arquero99/E-TEASPILS/img/16494115421077082039803952623791.png

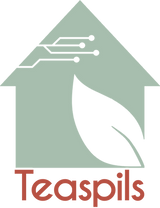
img/16494115421077082039803952623791.png
