arquero99/E-TEASPILS/img/IMG20220531001731-01.jpeg

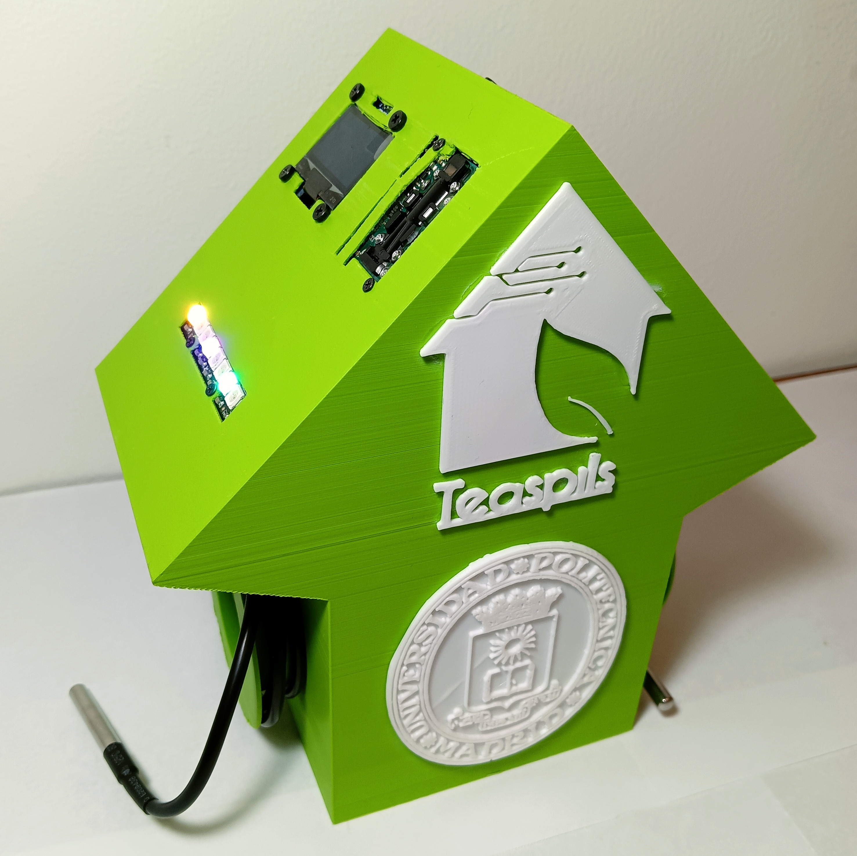
img/IMG20220531001731-01.jpeg
