arquero99/E-TEASPILS/img/pinout.jpg

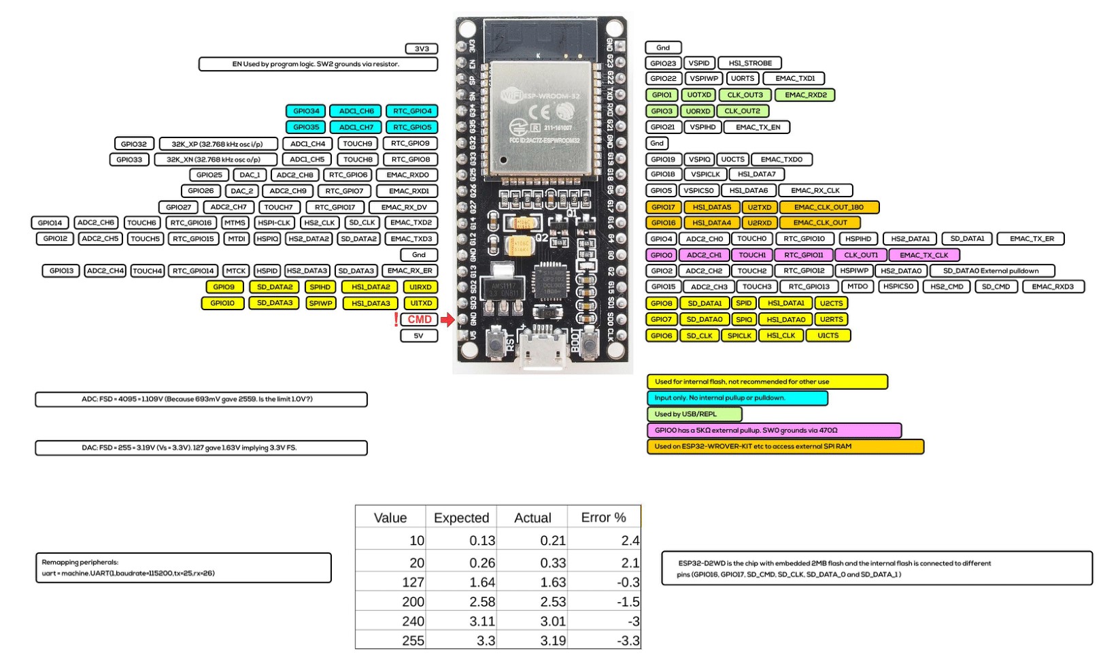
img/pinout.jpg
