arquero99/E-TEASPILS/SW/TB TeaSpike/Datasets/Dataset semanal/Semanal(7-02_15_02).png

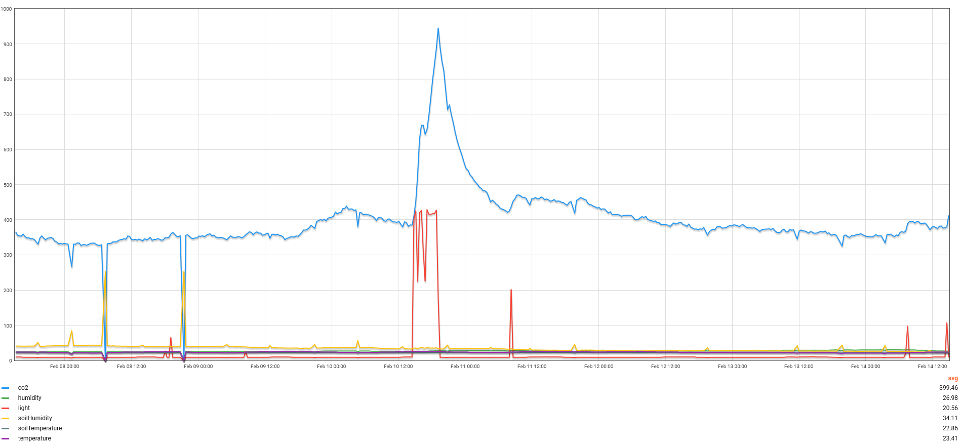
SW/TB TeaSpike/Datasets/Dataset semanal/Semanal(7-02_15_02).png
