arquero99/E-TEASPILS/HW/resources/Components.xlsx

Sheet: TeaSpike v1
Column1 | Column2 | Column3 | Column4 | Column5 | Column6 | Column7 | Column8 | Column9 | Link Compra
Source: | E:\Teaspils\E-TEASPILS\HW\KiCad project\TeaSpike v1\TeaSpike v1.kicad_sch
Date: | 18/04/2022 19:10:47
Tool: | Eeschema (6.0.4)
Generator: | E:\Programas\KiCad\6.0\bin\scripting\plugins/bom_csv_grouped_by_value.py
Component Count: | 24
Individual Components:
Item | Qty | Reference(s) | Value | LibPart | Footprint | Datasheet | MANUFACTURER | PARTREV
 |  | Batterycon1 | Conn_01x02 | Connector_Generic:Conn_01x02 | TerminalBlock:TerminalBlock_bornier-2_P5.08mm | ~
 |  | D1 | 1N4001 | Diode:1N4001 | Diode_THT:D_DO-41_SOD81_P10.16mm_Horizontal | http://www.vishay.com/docs/88503/1n4001.pdf
 |  | DISPLAYcon1 | Conn_01x04 | Connector_Generic:Conn_01x04 | Connector_JST:JST_EH_B4B-EH-A_1x04_P2.50mm_Vertical | ~
 |  | ESP32 | ESP32-DEVKITC-32D | ESP32-DEVKITC-32D:ESP32-DEVKITC-32D | ESP32-DEVKITC-32D:MODULE_ESP32-DEVKITC-32D |  | Espressif Systems | 4
 |  | I2Ccon1 | Conn_01x04 | Connector_Generic:Conn_01x04 | Connector_PinSocket_2.54mm:PinSocket_1x04_P2.54mm_Vertical | ~
 |  | JP1 | Jumper_2_Open | Jumper:Jumper_2_Open | Connector_PinHeader_2.54mm:PinHeader_1x02_P2.54mm_Vertical | ~
 |  | LEDSTRIPEcon1 | Conn_01x04 | Connector_Generic:Conn_01x04 | Connector_JST:JST_EH_B4B-EH-A_1x04_P2.50mm_Vertical | ~
 |  | NEOPIXELcon1 | Conn_02x02_Odd_Even | Connector_Generic:Conn_02x02_Odd_Even | Connector_PinSocket_2.54mm:PinSocket_2x02_P2.54mm_Vertical | ~
 |  | PowerSupplycon1 | Conn_01x03 | Connector_Generic:Conn_01x03 | Connector_PinSocket_2.54mm:PinSocket_1x03_P2.54mm_Vertical | ~
 |  | R1 | 1K | Device:R | Resistor_THT:R_Axial_DIN0207_L6.3mm_D2.5mm_P7.62mm_Horizontal | ~
 |  | R2 | 2K | Device:R | Resistor_THT:R_Axial_DIN0207_L6.3mm_D2.5mm_P7.62mm_Horizontal | ~
 |  | RTemp1 | 4K7 | Device:R | Resistor_THT:R_Axial_DIN0207_L6.3mm_D2.5mm_P7.62mm_Horizontal | ~
 |  | RTemp2 | 4K7 | Device:R | Resistor_THT:R_Axial_DIN0207_L6.3mm_D2.5mm_P7.62mm_Horizontal | ~
 |  | SDC30con1 | Conn_01x05 | Connector_Generic:Conn_01x05 | Connector_JST:JST_EH_B5B-EH-A_1x05_P2.50mm_Vertical | ~
 |  | SoilMoisturecon1 | Conn_01x03 | Connector_Generic:Conn_01x03 | Connector_PinHeader_2.54mm:PinHeader_1x03_P2.54mm_Vertical | ~
 |  | Solarcon1 | SolarPannel | Connector_Generic:Conn_01x02 | TerminalBlock:TerminalBlock_bornier-2_P5.08mm | ~
 |  | SW1 | SW_DPDT_x2 | Switch:SW_DPDT_x2 | Button_Switch_THT:SW_CuK_JS202011AQN_DPDT_Angled | ~
 |  | TempProbe1 | Conn_01x03 | Connector_Generic:Conn_01x03 | Connector_JST:JST_EH_B3B-EH-A_1x03_P2.50mm_Vertical | ~
 |  | TempProbe2 | Conn_01x03 | Connector_Generic:Conn_01x03 | Connector_JST:JST_EH_B3B-EH-A_1x03_P2.50mm_Vertical | ~
 |  | U1 | TP4056 | TeaSpike_Periferalls:TP4056 | TeaSpike_Periferalls:TP4056
 |  | U2 | PowerBoost | TeaSpike_Periferalls:PowerBoost | TeaSpike_Periferalls:PowerBoost
 |  | U_RTC1 | RTC_I2C_Module | TeaSpike_Periferalls:RTC_I2C_Module | TeaSpike_Periferalls:RTC_I2C_Module
 |  | U_SD1 | SD_Module | TeaSpike_Periferalls:SD_Module | TeaSpike_Periferalls:SD_Module
 |  | VEML7700con1 | Conn_01x04 | Connector_Generic:Conn_01x04 | Connector_JST:JST_EH_B4B-EH-A_1x04_P2.50mm_Vertical | ~
Collated Components:
Item | Qty | Reference(s) | Value | LibPart | Footprint | Datasheet | MANUFACTURER | PARTREV
1 | 1 | Batterycon1 | Conn_01x02 | Connector_Generic:Conn_01x02 | TerminalBlock:TerminalBlock_bornier-2_P5.08mm | ~
2 | 1 | D1 | 1N4001 | Diode:1N4001 | Diode_THT:D_DO-41_SOD81_P10.16mm_Horizontal | http://www.vishay.com/docs/88503/1n4001.pdf
3 | 3 | DISPLAYcon1, LEDSTRIPEcon1, VEML7700con1 | Conn_01x04 | Connector_Generic:Conn_01x04 | Connector_JST:JST_EH_B4B-EH-A_1x04_P2.50mm_Vertical | ~
4 | 1 | ESP32 | ESP32-DEVKITC-32D | ESP32-DEVKITC-32D:ESP32-DEVKITC-32D | ESP32-DEVKITC-32D:MODULE_ESP32-DEVKITC-32D |  | Espressif Systems | 4
5 | 1 | I2Ccon1 | Conn_01x04 | Connector_Generic:Conn_01x04 | Connector_PinSocket_2.54mm:PinSocket_1x04_P2.54mm_Vertical | ~
6 | 1 | JP1 | Jumper_2_Open | Jumper:Jumper_2_Open | Connector_PinHeader_2.54mm:PinHeader_1x02_P2.54mm_Vertical | ~
7 | 1 | NEOPIXELcon1 | Conn_02x02_Odd_Even | Connector_Generic:Conn_02x02_Odd_Even | Connector_PinSocket_2.54mm:PinSocket_2x02_P2.54mm_Vertical | ~
8 | 1 | PowerSupplycon1 | Conn_01x03 | Connector_Generic:Conn_01x03 | Connector_PinSocket_2.54mm:PinSocket_1x03_P2.54mm_Vertical | ~
9 | 1 | R1 | 1K | Device:R | Resistor_THT:R_Axial_DIN0207_L6.3mm_D2.5mm_P7.62mm_Horizontal | ~
10 | 1 | R2 | 2K | Device:R | Resistor_THT:R_Axial_DIN0207_L6.3mm_D2.5mm_P7.62mm_Horizontal | ~
11 | 2 | RTemp1, RTemp2 | 4K7 | Device:R | Resistor_THT:R_Axial_DIN0207_L6.3mm_D2.5mm_P7.62mm_Horizontal | ~
12 | 1 | SDC30con1 | Conn_01x05 | Connector_Generic:Conn_01x05 | Connector_JST:JST_EH_B5B-EH-A_1x05_P2.50mm_Vertical | ~
13 | 1 | SoilMoisturecon1 | Conn_01x03 | Connector_Generic:Conn_01x03 | Connector_PinHeader_2.54mm:PinHeader_1x03_P2.54mm_Vertical | ~
14 | 1 | Solarcon1 | SolarPannel | Connector_Generic:Conn_01x02 | TerminalBlock:TerminalBlock_bornier-2_P5.08mm | ~
15 | 1 | SW1 | SW_DPDT_x2 | Switch:SW_DPDT_x2 | Button_Switch_THT:SW_CuK_JS202011AQN_DPDT_Angled | ~
16 | 2 | TempProbe1, TempProbe2 | Conn_01x03 | Connector_Generic:Conn_01x03 | Connector_JST:JST_EH_B3B-EH-A_1x03_P2.50mm_Vertical | ~
17 | 1 | U1 | TP4056 | TeaSpike_Periferalls:TP4056 | TeaSpike_Periferalls:TP4056
18 | 1 | U2 | PowerBoost | TeaSpike_Periferalls:PowerBoost | TeaSpike_Periferalls:PowerBoost
19 | 1 | U_RTC1 | RTC_I2C_Module | TeaSpike_Periferalls:RTC_I2C_Module | TeaSpike_Periferalls:RTC_I2C_Module
20 | 1 | U_SD1 | SD_Module | TeaSpike_Periferalls:SD_Module | TeaSpike_Periferalls:SD_Module

Sheet: Hoja2
Item | Qty | Reference(s) | Footprint | Link Compra
1 | 1 | Batterycon1 | TerminalBlock:TerminalBlock_bornier-2_P5.08mm | https://es.rs-online.com/web/p/bloques-terminales-para-pcb/1895843/
2 | 1 | D1 | Diode_THT:D_DO-41_SOD81_P10.16mm_Horizontal | https://es.rs-online.com/web/p/diodos-schottky-y-rectificadores/6288931/
3 | 3 | DISPLAYcon1, LEDSTRIPEcon1, VEML7700con1 | Connector_JST:JST_EH_B4B-EH-A_1x04_P2.50mm_Vertical | https://es.rs-online.com/web/p/conectores-macho-para-pcb/5151406/
4 | 1 | ESP32 | ESP32-DEVKITC-32D:MODULE_ESP32-DEVKITC-32D
5 | 1 | I2Ccon1 | Connector_PinSocket_2.54mm:PinSocket_1x04_P2.54mm_Vertical | https://es.rs-online.com/web/p/conectores-hembra-para-pcb/2518193/
6 | 1 | JP1 | Connector_PinHeader_2.54mm:PinHeader_1x02_P2.54mm_Vertical | https://es.rs-online.com/web/p/conectores-hembra-para-pcb/2518171/
7 | 1 | NEOPIXELcon1 | Connector_PinSocket_2.54mm:PinSocket_2x02_P2.54mm_Vertical | https://es.rs-online.com/web/p/conectores-hembra-para-pcb/6816839/
8 | 1 | PowerSupplycon1 | Connector_PinSocket_2.54mm:PinSocket_1x03_P2.54mm_Vertical | https://es.rs-online.com/web/p/conectores-hembra-para-pcb/2518187/
9 | 1 | R1 | Resistor_THT:R_Axial_DIN0207_L6.3mm_D2.5mm_P7.62mm_Horizontal
10 | 1 | R2 | Resistor_THT:R_Axial_DIN0207_L6.3mm_D2.5mm_P7.62mm_Horizontal
11 | 2 | RTemp1, RTemp2 | Resistor_THT:R_Axial_DIN0207_L6.3mm_D2.5mm_P7.62mm_Horizontal
12 | 1 | SDC30con1 | Connector_JST:JST_EH_B5B-EH-A_1x05_P2.50mm_Vertical | https://es.rs-online.com/web/p/conectores-macho-para-pcb/5151412/
13 | 1 | SoilMoisturecon1 | Connector_PinHeader_2.54mm:PinHeader_1x03_P2.54mm_Vertical | https://es.rs-online.com/web/p/conectores-macho-para-pcb/2518301/
14 | 1 | Solarcon1 | TerminalBlock:TerminalBlock_bornier-2_P5.08mm
15 | 1 | SW1 | Button_Switch_THT:SW_CuK_JS202011AQN_DPDT_Angled | https://es.rs-online.com/web/p/interruptores-de-actuador-deslizante/1238920/
16 | 2 | TempProbe1, TempProbe2 | Connector_JST:JST_EH_B3B-EH-A_1x03_P2.50mm_Vertical | https://es.rs-online.com/web/p/conectores-macho-para-pcb/5468243/
17 | 1 | U1 | TeaSpike_Periferalls:TP4056
18 | 1 | U2 | TeaSpike_Periferalls:PowerBoost
19 | 1 | U_RTC1 | TeaSpike_Periferalls:RTC_I2C_Module
20 | 1 | U_SD1 | TeaSpike_Periferalls:SD_Module
