arquero99/E-TEASPILS/HW/KiCad project/TeaSpike v1/TeaSpike v1.csv

Source: | E:\Teaspils\E-TEASPILS\HW\KiCad project\TeaSpike v1\TeaSpike v1.kicad_sch
Date: | 18/04/2022 19:15:25
Tool: | Eeschema (6.0.4)
Generator: | E:\Programas\KiCad\6.0\bin\scripting\plugins/bom_csv_grouped_by_value_with_fp.py
Component Count: | 24
Ref | Qnty | Value | Cmp name | Footprint | Description | Vendor
Batterycon1, | 1 | Conn_01x02 | Conn_01x02 | TerminalBlock:TerminalBlock_bornier-2_P5.08mm | Generic connector, single row, 01x02, script generated (kicad-library-utils/schlib/autogen/connector/)
D1, | 1 | 1N4001 | 1N4001 | Diode_THT:D_DO-41_SOD81_P10.16mm_Horizontal | 50V 1A General Purpose Rectifier Diode, DO-41
DISPLAYcon1, | 1 | Conn_01x04 | Conn_01x04 | Connector_JST:JST_EH_B4B-EH-A_1x04_P2.50mm_Vertical | Generic connector, single row, 01x04, script generated (kicad-library-utils/schlib/autogen/connector/)
ESP32, | 1 | ESP32-DEVKITC-32D | ESP32-DEVKITC-32D | ESP32-DEVKITC-32D:MODULE_ESP32-DEVKITC-32D
I2Ccon1, | 1 | Conn_01x04 | Conn_01x04 | Connector_PinSocket_2.54mm:PinSocket_1x04_P2.54mm_Vertical | Generic connector, single row, 01x04, script generated (kicad-library-utils/schlib/autogen/connector/)
JP1, | 1 | Jumper_2_Open | Jumper_2_Open | Connector_PinHeader_2.54mm:PinHeader_1x02_P2.54mm_Vertical | Jumper, 2-pole, open
LEDSTRIPEcon1, | 1 | Conn_01x04 | Conn_01x04 | Connector_JST:JST_EH_B4B-EH-A_1x04_P2.50mm_Vertical | Generic connector, single row, 01x04, script generated (kicad-library-utils/schlib/autogen/connector/)
NEOPIXELcon1, | 1 | Conn_02x02_Odd_Even | Conn_02x02_Odd_Even | Connector_PinSocket_2.54mm:PinSocket_2x02_P2.54mm_Vertical | Generic connector, double row, 02x02, odd/even pin numbering scheme (row 1 odd numbers, row 2 even numbers), script generated (kicad-library-utils/schlib/autogen/connector/)
PowerSupplycon1, | 1 | Conn_01x03 | Conn_01x03 | Connector_PinSocket_2.54mm:PinSocket_1x03_P2.54mm_Vertical | Generic connector, single row, 01x03, script generated (kicad-library-utils/schlib/autogen/connector/)
R1, | 1 | 1K | R | Resistor_THT:R_Axial_DIN0207_L6.3mm_D2.5mm_P7.62mm_Horizontal | Resistor
R2, | 1 | 2K | R | Resistor_THT:R_Axial_DIN0207_L6.3mm_D2.5mm_P7.62mm_Horizontal | Resistor
RTemp1, RTemp2, | 2 | 4K7 | R | Resistor_THT:R_Axial_DIN0207_L6.3mm_D2.5mm_P7.62mm_Horizontal | Resistor
SDC30con1, | 1 | Conn_01x05 | Conn_01x05 | Connector_JST:JST_EH_B5B-EH-A_1x05_P2.50mm_Vertical | Generic connector, single row, 01x05, script generated (kicad-library-utils/schlib/autogen/connector/)
SoilMoisturecon1, | 1 | Conn_01x03 | Conn_01x03 | Connector_PinHeader_2.54mm:PinHeader_1x03_P2.54mm_Vertical | Generic connector, single row, 01x03, script generated (kicad-library-utils/schlib/autogen/connector/)
Solarcon1, | 1 | SolarPannel | Conn_01x02 | TerminalBlock:TerminalBlock_bornier-2_P5.08mm | Generic connector, single row, 01x02, script generated (kicad-library-utils/schlib/autogen/connector/)
SW1, | 1 | SW_DPDT_x2 | SW_DPDT_x2 | Button_Switch_THT:SW_CuK_JS202011AQN_DPDT_Angled | Switch, dual pole double throw, separate symbols
TempProbe1, TempProbe2, | 2 | Conn_01x03 | Conn_01x03 | Connector_JST:JST_EH_B3B-EH-A_1x03_P2.50mm_Vertical | Generic connector, single row, 01x03, script generated (kicad-library-utils/schlib/autogen/connector/)
U1, | 1 | TP4056 | TP4056 | TeaSpike_Periferalls:TP4056
U2, | 1 | PowerBoost | PowerBoost | TeaSpike_Periferalls:PowerBoost
U_RTC1, | 1 | RTC_I2C_Module | RTC_I2C_Module | TeaSpike_Periferalls:RTC_I2C_Module
U_SD1, | 1 | SD_Module | SD_Module | TeaSpike_Periferalls:SD_Module
VEML7700con1, | 1 | Conn_01x04 | Conn_01x04 | Connector_JST:JST_EH_B4B-EH-A_1x04_P2.50mm_Vertical | Generic connector, single row, 01x04, script generated (kicad-library-utils/schlib/autogen/connector/)
