arquero99/E-TEASPILS/HW/resources/schematic.pdf

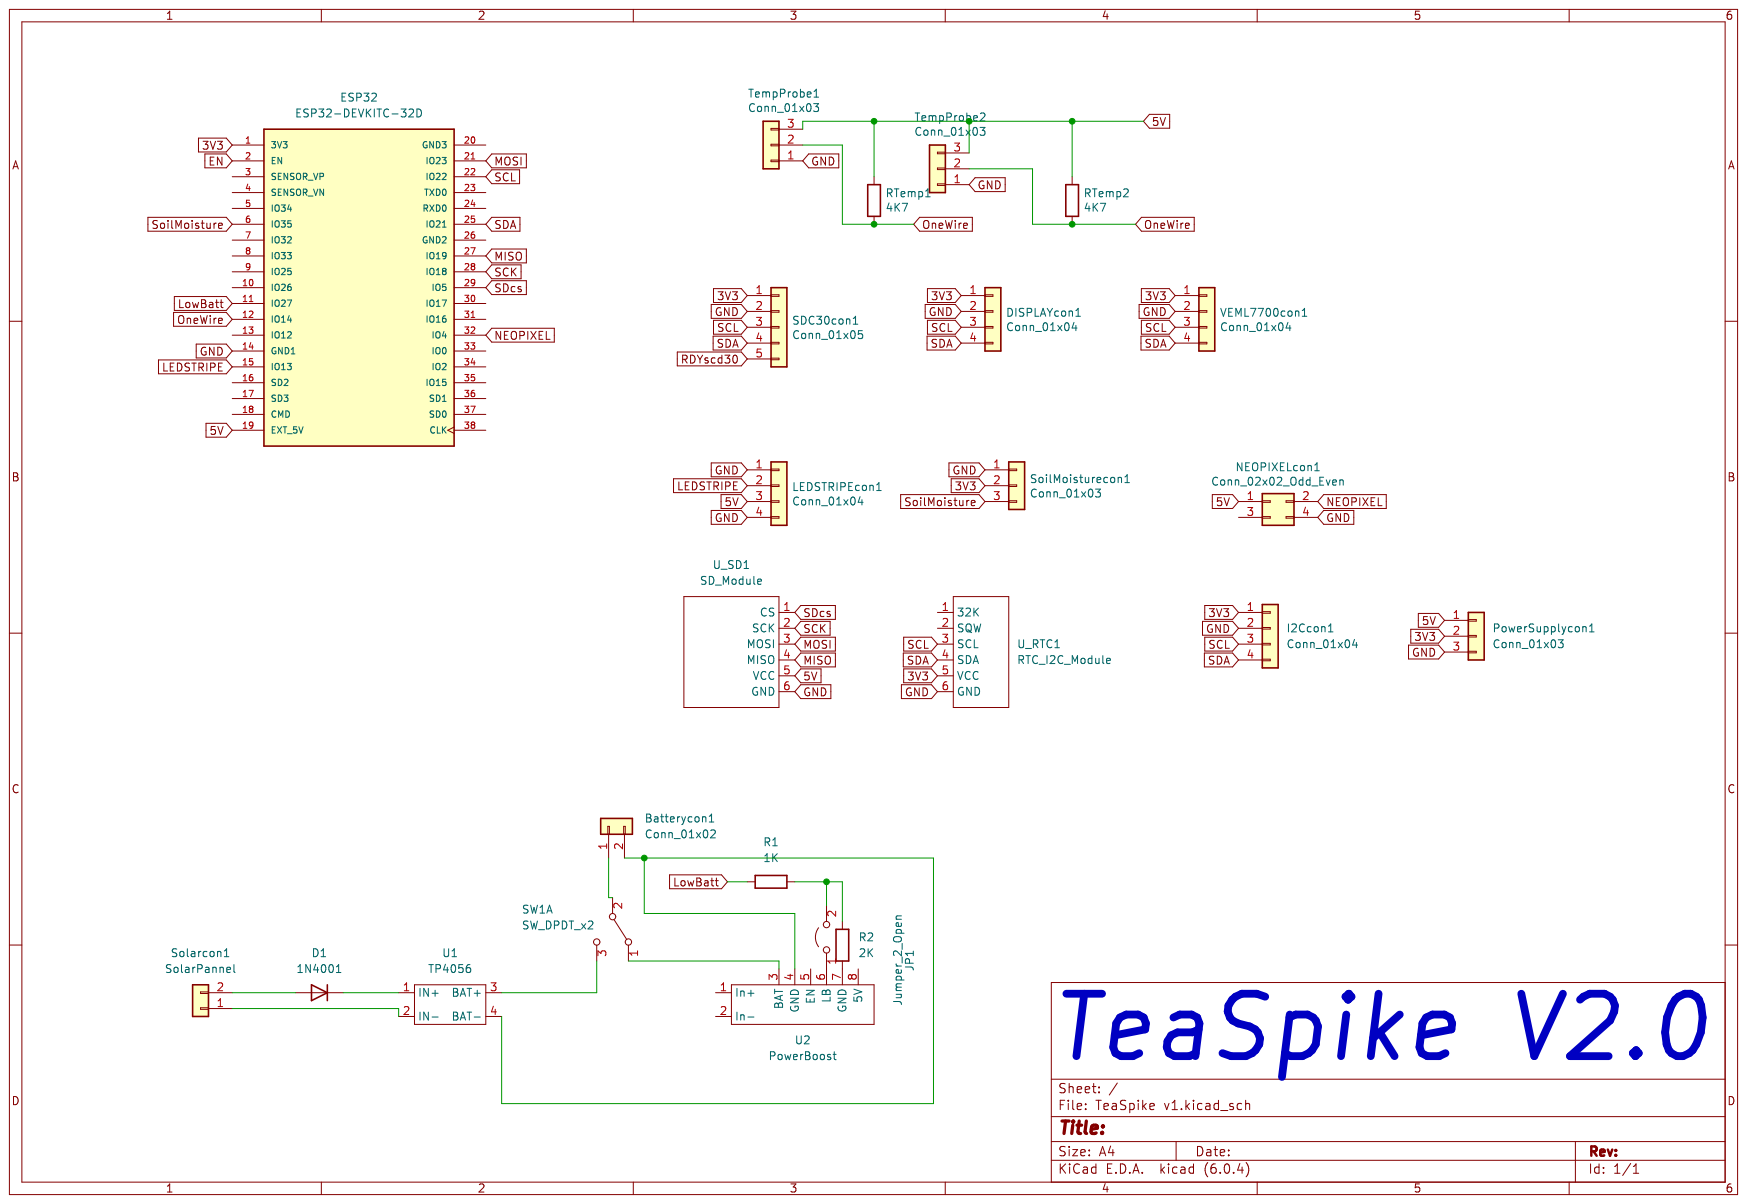
[picture p8: page 1]
