arquero99/E-TEASPILS/HW/resources/mask.pdf

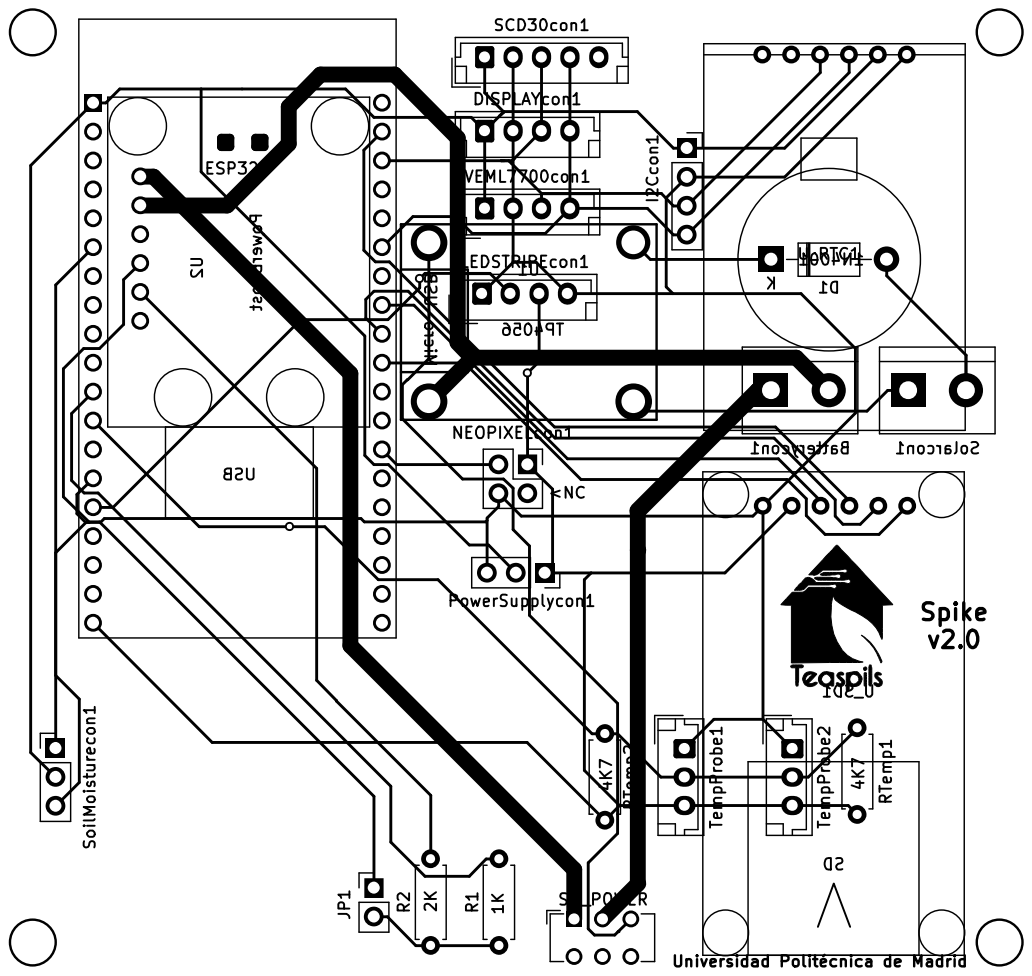
[picture p9: page 1]
