arquero99/E-TEASPILS/(list of files, drawings)

Other design files:
HW/KiCad project/TeaSpike v1/TeaSpike v1.dsn
SW/V0/Esquema.fzz
