arquero99/E-TEASPILS/HW/KiCad project/TeaSpike v1/TeaSpike v1.kicad_pcb

## KiCad design HW/KiCad project/TeaSpike v1/TeaSpike v1.kicad_pcb (2022-05-29)

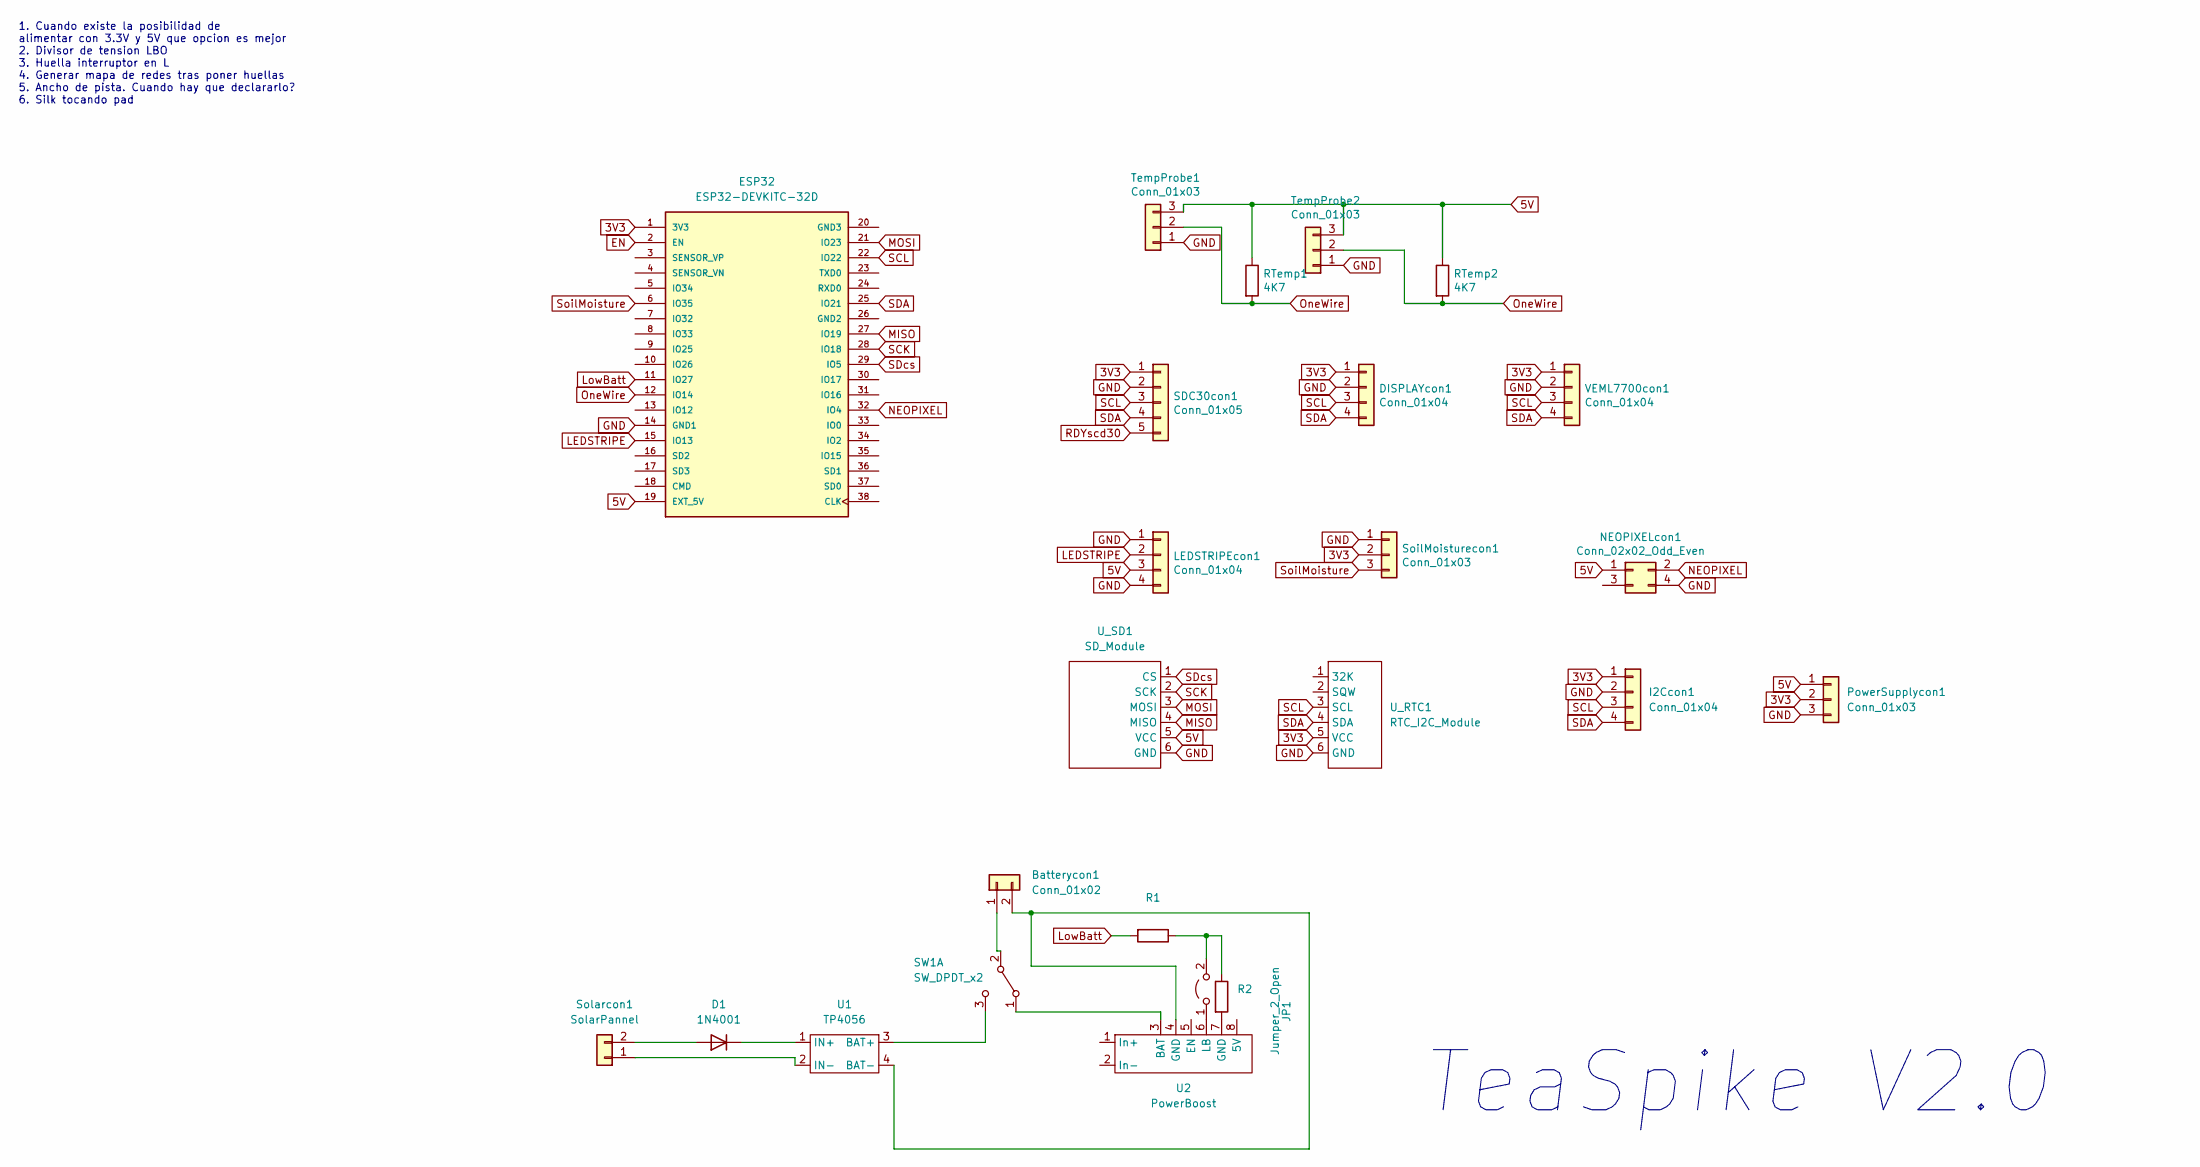
[picture p10: schematic TeaSpike v1.kicad_sch]

Parts:
Batterycon1: Conn_01x02; TerminalBlock_bornier-2_P5.08mm
D1: 1N4001; D_DO-41_SOD81_P10.16mm_Horizontal
DISPLAYcon1: Conn_01x04; JST_EH_B4B-EH-A_1x04_P2.50mm_Vertical
ESP32: ESP32-DEVKITC-32D; MODULE_ESP32-DEVKITC-32D; PARTREV 4
I2Ccon1: Conn_01x04; PinSocket_1x04_P2.54mm_Vertical
JP1: Jumper_2_Open; PinHeader_1x02_P2.54mm_Vertical
LEDSTRIPEcon1: Conn_01x04; JST_EH_B4B-EH-A_1x04_P2.50mm_Vertical
NEOPIXELcon1: Conn_02x02_Odd_Even; PinSocket_2x02_P2.54mm_Vertical
PowerSupplycon1: Conn_01x03; PinSocket_1x03_P2.54mm_Vertical
R1, R2: R_Axial_DIN0207_L6.3mm_D2.5mm_P7.62mm_Horizontal
RTemp1, RTemp2: 4K7; R_Axial_DIN0207_L6.3mm_D2.5mm_P7.62mm_Horizontal
SDC30con1: Conn_01x05; JST_EH_B5B-EH-A_1x05_P2.50mm_Vertical
SW1: SW_DPDT_x2; SW_CuK_JS202011AQN_DPDT_Angled
SoilMoisturecon1: Conn_01x03; PinHeader_1x03_P2.54mm_Vertical
Solarcon1: SolarPannel; TerminalBlock_bornier-2_P5.08mm
TempProbe1, TempProbe2: Conn_01x03; JST_EH_B3B-EH-A_1x03_P2.50mm_Vertical
U1: TP4056
U2: PowerBoost
U_RTC1: RTC_I2C_Module
U_SD1: SD_Module
VEML7700con1: Conn_01x04; JST_EH_B4B-EH-A_1x04_P2.50mm_Vertical

Connections:
3V3: DISPLAYcon1.1, ESP32.1 (3V3), I2Ccon1.1, PowerSupplycon1.2, SDC30con1.1, SoilMoisturecon1.2, U_RTC1.5 (VCC), VEML7700con1.1; also elsewhere on the board
5V: ESP32.19 (EXT_5V), LEDSTRIPEcon1.3, NEOPIXELcon1.1, PowerSupplycon1.1, RTemp1.1, RTemp2.1, TempProbe1.3, TempProbe2.3, U_SD1.5 (VCC)
EN: ESP32.2 (EN)
GND: DISPLAYcon1.2, ESP32.14 (GND1), I2Ccon1.2, LEDSTRIPEcon1.1, LEDSTRIPEcon1.4, NEOPIXELcon1.4, PowerSupplycon1.3, SDC30con1.2, SoilMoisturecon1.1, TempProbe1.1, TempProbe2.1, U_RTC1.6 (GND), U_SD1.6 (GND), VEML7700con1.2; also elsewhere on the board
LEDSTRIPE: ESP32.15 (IO13), LEDSTRIPEcon1.2
LowBatt: ESP32.11 (IO27), R1.2
MISO: ESP32.27 (IO19), U_SD1.4 (MISO)
MOSI: ESP32.21 (IO23), U_SD1.3 (MOSI)
NEOPIXEL: ESP32.32 (IO4), NEOPIXELcon1.2
unnamed 9: Batterycon1.1, SW1.2 (B); also elsewhere on the board
unnamed: Batterycon1.2, U1.4 (BAT-), U2.4 (GND)
unnamed: D1.1 (K), U1.1 (IN+)
unnamed: D1.2 (A), Solarcon1.2
unnamed: JP1.1 (A), U2.6 (LB)
unnamed: JP1.2 (B), R1.1, R2.1
unnamed: R2.2, U2.7 (GND)
unnamed 16: SW1.1 (A), U2.3 (BAT); also elsewhere on the board
unnamed 17: SW1.3 (C), U1.3 (BAT+); also elsewhere on the board
unnamed: Solarcon1.1, U1.2 (IN-)
OneWire: ESP32.12 (IO14), RTemp1.2, RTemp2.2, TempProbe1.2, TempProbe2.2
SCK: ESP32.28 (IO18), U_SD1.2 (SCK)
SCL: DISPLAYcon1.3, ESP32.22 (IO22), I2Ccon1.3, SDC30con1.3, U_RTC1.3 (SCL), VEML7700con1.3; also elsewhere on the board
SDA: DISPLAYcon1.4, ESP32.25 (IO21), I2Ccon1.4, SDC30con1.4, U_RTC1.4 (SDA), VEML7700con1.4; also elsewhere on the board
SDcs: ESP32.29 (IO5), U_SD1.1 (CS)
SoilMoisture: ESP32.6 (IO35), SoilMoisturecon1.3

Notes on the sheet:
TeaSpike V2.0
1. Cuando existe la posibilidad de alimentar con 3.3V y 5V que opcion es mejor 2. Divisor de tension LBO 3. Huella interruptor en L 4. Generar mapa de redes tras poner huellas 5. Ancho de pista. Cuando hay que declararlo? 6. Silk tocando pad

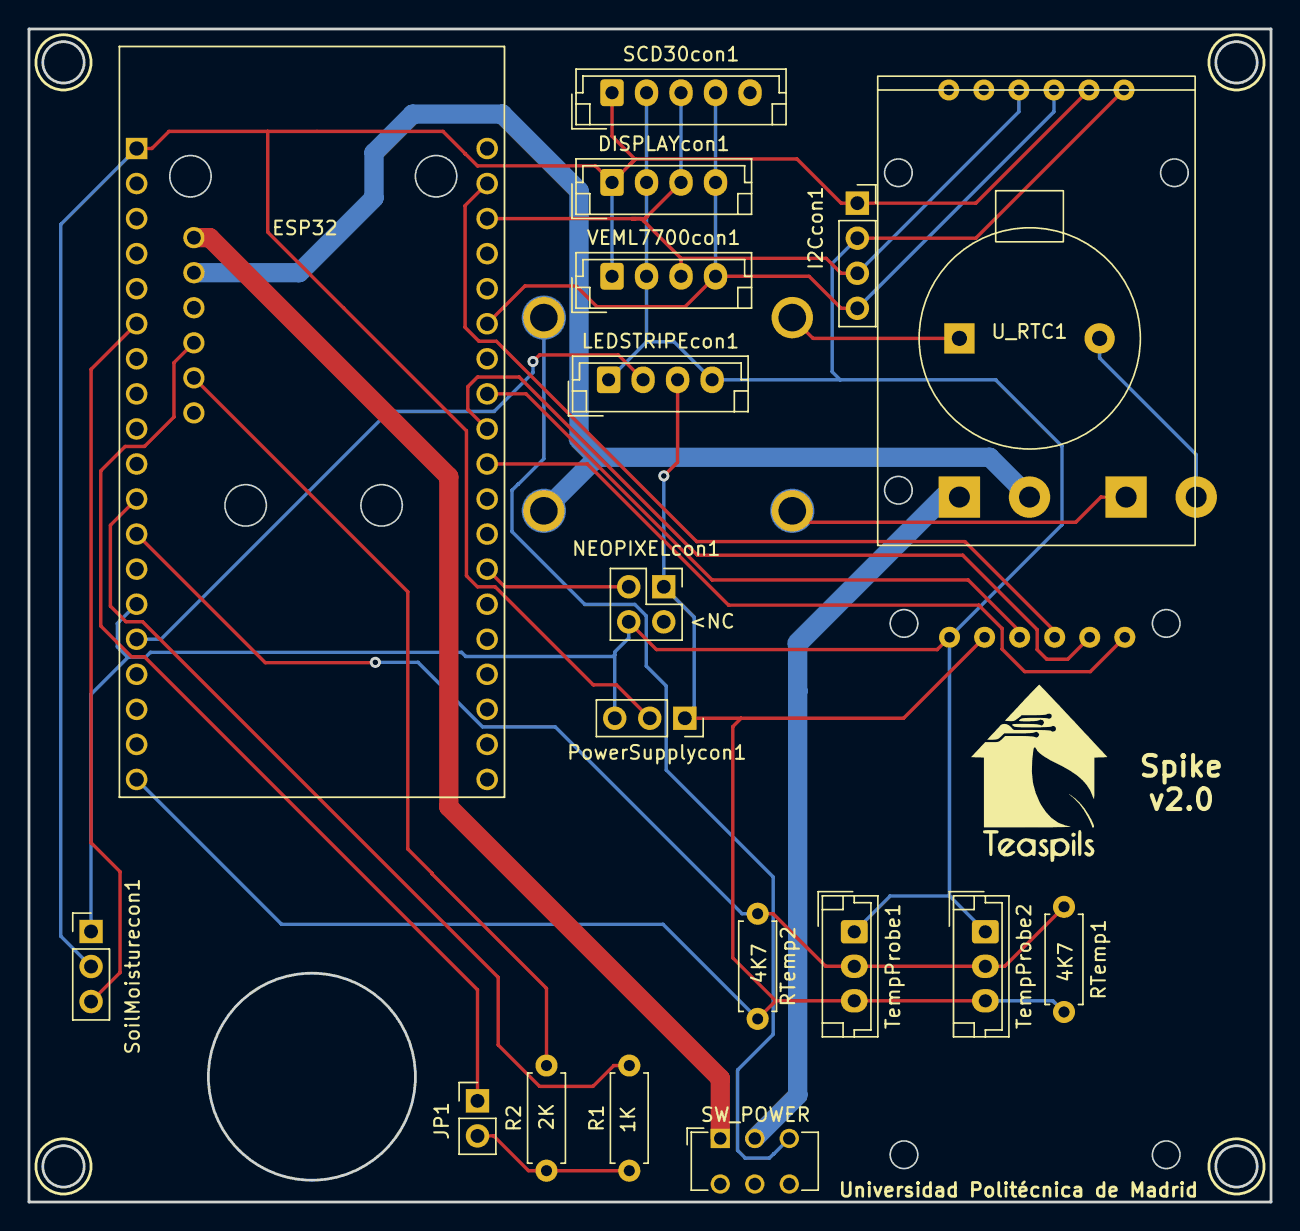
[picture p11: board TeaSpike v1.kicad_pcb from above]

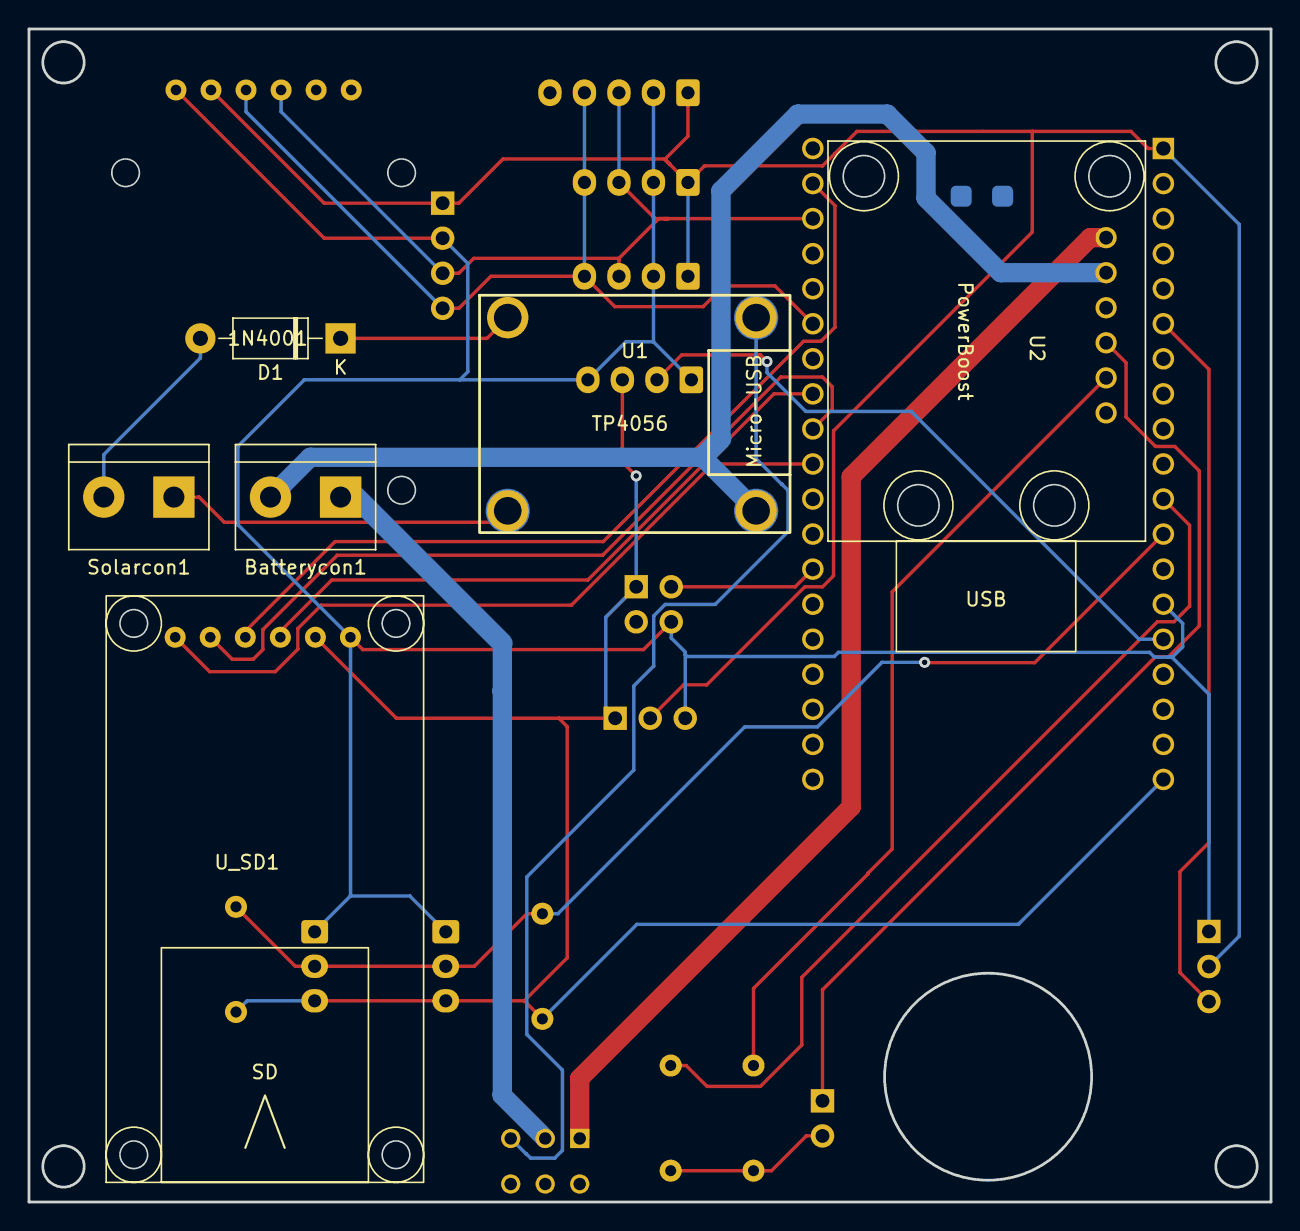
[picture p12: board TeaSpike v1.kicad_pcb from below]

Board: 2 copper layers, 90.0 x 85.0 mm, 24 parts (6 on the bottom side), 24 nets.

Other parts of the board:
SCD30con1: Conn_01x05; JST_EH_B5B-EH-A_1x05_P2.50mm_Vertical
SW_POWER: SW_DPDT_x2; SW_CuK_JS202011AQN_DPDT_Angled

Their connections:
3V3: SCD30con1.1; also elsewhere on the board
GND: SCD30con1.2; also elsewhere on the board
unnamed 9: SW_POWER.2 (B); also elsewhere on the board
unnamed 16: SW_POWER.1 (A); also elsewhere on the board
unnamed 17: SW_POWER.3 (C); also elsewhere on the board
SCL: SCD30con1.3; also elsewhere on the board
SDA: SCD30con1.4; also elsewhere on the board
