arquero99/E-TEASPILS/HW/resources/KiCad files/Adafruit-PowerBoost-1000-PCB-master/Adafruit PowerBoost 1000 Basic.brd

## EAGLE design HW/resources/KiCad files/Adafruit-PowerBoost-1000-PCB-master/Adafruit PowerBoost 1000 Basic.brd (2022-05-29)

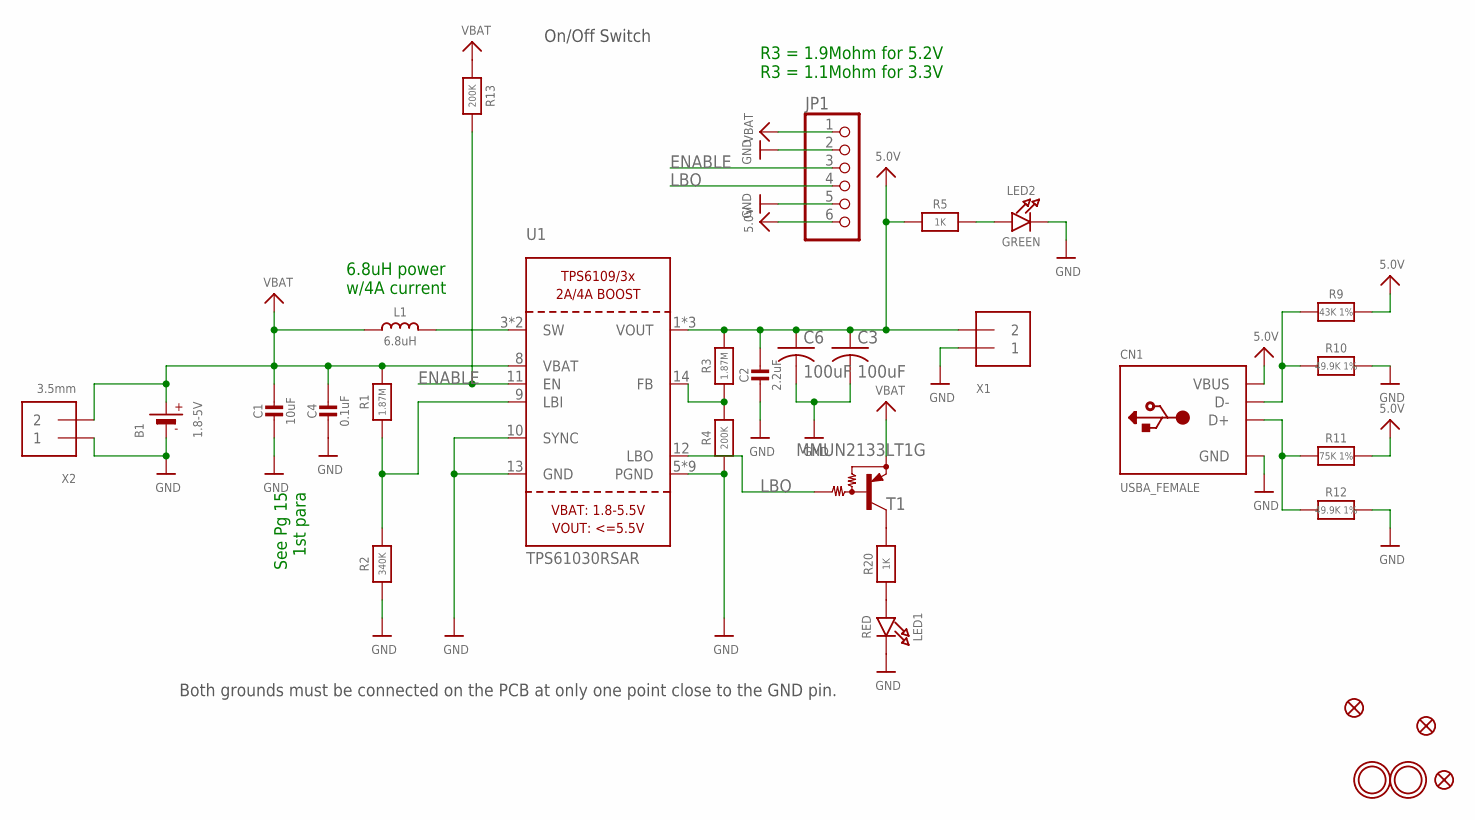
[picture p13: schematic Adafruit PowerBoost 1000 Basic.sch]

Parts:
B1: 1.8-5V; JSTPH2
C1: 10uF; 0805-NO
C2: 2.2uF; 0805-NO
C3, C6: 100uF; C1210
C4: 0.1uF; 0805-NO
CN1: USBA_FEMALE; USB_HOST-PTH
FID1, FID2, FID3: FIDUCIAL""; FIDUCIAL_1MM
JP1: PINHD-1X6CB; 1X06-CLEANBIG
L1: 6.8uH; INDUCTOR_8X8MM
LED1: RED; CHIPLED_0805_NOOUTLINE
LED2: GREEN; CHIPLED_0805_NOOUTLINE
R1, R3: 1.87M; _0805MP
R2: 340K; _0805MP
R4, R13: 200K; 0805-NO
R5, R20: 1K; 0805-NO
R9: 43K 1%; 0805-NO
R10, R12: 49.9K 1%; 0805-NO
R11: 75K 1%; 0805-NO
T1: MMUN2133LT1G; SC59-BEC
U1: TPS61030RSAR; PVQFN-16
U$10, U$11: MOUNTINGHOLE2.5; MOUNTINGHOLE_2.5_PLATED
X1: TERMBLOCK_1X2; TERMBLOCK_1X2-3.5MM
X2: 3.5mm; TERMBLOCK_1X2-3.5MM

Connections:
5.0V: C2.1, C3.1, C6.1, CN1.VBUS, JP1.6, R3.2, R5.1, R9.2, R11.2, U1.1 (VOUT), U1.15 (VOUT), U1.16 (VOUT), X1.2
D+: CN1.D+, R11.1, R12.1
D-: CN1.D-, R9.1, R10.1
ENABLE: JP1.3, R13.2, U1.11 (EN)
GND: B1.1 (-), C1.2, C2.2, C3.2, C4.2, C6.2, CN1.GND, JP1.2, JP1.5, LED1.C, LED2.C, R2.1, R4.1, R10.2, R12.2, U1.5 (PGND), U1.6 (PGND), U1.7 (PGND), U1.10 (SYNC), U1.13 (GND), U1.P$18 (PGND), U1.P$19 (PGND), U1.P$20 (PGND), U1.P$21 (PGND), U1.P$22 (PGND), U1.THERMAL (PGND), X1.1, X2.1
LBO: JP1.4, T1.B, U1.12 (LBO)
unnamed: L1.P$2 (2), U1.3 (SW), U1.4 (SW)
unnamed: LED1.A, R20.1
unnamed: R1.1, R2.2, U1.9 (LBI)
unnamed: LED2.A, R5.2
unnamed: R3.1, R4.2, U1.14 (FB)
unnamed: R20.2, T1.C
VBAT: B1.2 (+), C1.1, C4.1, JP1.1, L1.P$1 (1), R1.2, R13.1, T1.E, U1.8 (VBAT), X2.2

Notes on the sheet:
Both grounds must be connected on the PCB at only one point close to the GND pin.
On/Off Switch
See Pg 15 1st para
6.8uH power w/4A current
R3 = 1.9Mohm for 5.2V R3 = 1.1Mohm for 3.3V

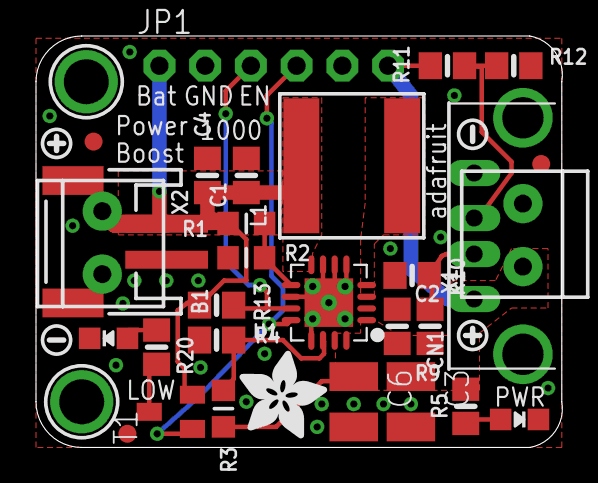
[picture p14: board Adafruit PowerBoost 1000 Basic.brd from above]

Board: 2 copper layers, 29.2 x 22.9 mm, 37 parts (1 on the bottom side), 13 nets.

Other parts of the board:
U$12, U$26: SYMBOL_MINUS
U$13, U$25: SYMBOL_PLUS
U$28, U$33: ADAFRUIT_5MM
