arquero99/E-TEASPILS/SW/V3_TeaSpike/include/configuration.h

#ifndef CONFIGURATION_HPP
#define CONFIGURATION_HPP

#define VERSION "V3"

#define BAUD_RATE 9600

#define NUMPIXELS 8
#define RING_PIN 13 
#define NEOPIXEL_PIN 4

//cadencia por sensor en segundos
#define ambPeriod 5
#define soilPeriod 5

//Period of data uploading
#define DEFAULT_PERIOD 60      //Arround 5min

#define CHECK_OLED false

//Clock
#define GMT_OFFSET 7200
#define GMT_DST 0


//PINMAP
const int LIGHT_SENSOR_PIN = 32;
const int SOILHUMIDITY_SENSOR_PIN = 35;
const int SD_PIN = 17;  
const int SOILTEMP_SENSOR_PIN = 14;    

//Puerto del servidor HTTP
int mqtt_service_port = 1883;


String LogInitialMessage="timestamp;co2;humidity;temperature;light;soiltemperature1;soilTemperature2;errorLog";


//Cambio de dato en modo carrusel
boolean carruselON=false;
int cambio=3000;

//Fuentes para la pantalla
extern uint8_t SmallFont[];// Selecciono el tamaño de fuente para los textos es necesario declararlo 
extern uint8_t TinyFont[];// Selecciono el tamaño de fuente para los textos es necesario declararlo 
extern uint8_t MediumNumbers[];// Selecciono el tamaño de fuente para los numeros
extern uint8_t BigNumbers[];// Selecciono el tamaño de fuente para los numeros

uint8_t LOGO[] PROGMEM={


0x00, 0x00, 0x00, 0x00, 0x00, 0x00, 0x00, 0x00, 0x00, 0x00, 0x00, 0x00, 0x00, 0x00, 0x00, 0x00, 
0x00, 0x00, 0x00, 0x00, 0x00, 0x00, 0x00, 0x02, 0x00, 0x00, 0x00, 0x00, 0x00, 0x00, 0x00, 0x00, 
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
0x00, 0x00, 0x00, 0x00, 0x1f, 0xff, 0xff, 0xfc, 0x00, 0x00, 0x0f, 0xc0, 0x00, 0x00, 0x00, 0x00, 
0x00, 0x00, 0x00, 0x00, 0x1f, 0xff, 0xff, 0xfc, 0x00, 0x00, 0x07, 0xc0, 0x00, 0x00, 0x00, 0x00, 
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
};



#endif
