arquero99/E-TEASPILS/SW/V0/configuration.h

#ifndef CONFIGURATION_HPP
#define CONFIGURATION_HPP

/* puerto del servidor HTTP */
int mqtt_service_port = 1883;

// velocidad a la que se comunicará con un puerto serie
const int SERIAL_BAUDIOS = 115200;

String LogInitialMessage="Version 1.0 26/02/2021 Juan Luis Moreno Sancho\nValores actuales de configuracion:\nclave1 [valor1]\nclave2 [valor2]\n...\nclaven [valorn]\ndate;sensorid;value";

String CO2_ID = "co2_X21";
String Humidity_ID = "humidit_r6h3y";
String Temp_ID = "temp_s213";
String Light_ID = "light_d2q11";
String Loudness_ID = "loudness_xx11";
String SoilHumidity_ID = "soilhumid_cc99r";


//cadencia por sensor
int light = 1;
int air = 1;
int soilHumidity = 1;
int loudness = 1;

int LIGHT_SENSOR_PIN = 32;
int SOILHUMIDITY_SENSOR_PIN = 36;
int LOUDNESS_SENSOR_PIN = 35;
//delay de envio 30 seg
int envio=60;

//cambio de dato en modo carrusel
boolean carruselON=false;
int cambio=3000;

//Fuentes para la pantalla
extern uint8_t SmallFont[];// Selecciono el tamaño de fuente para los textos es necesario declararlo 
extern uint8_t TinyFont[];// Selecciono el tamaño de fuente para los textos es necesario declararlo 
extern uint8_t MediumNumbers[];// Selecciono el tamaño de fuente para los numeros
extern uint8_t BigNumbers[];// Selecciono el tamaño de fuente para los numeros

uint8_t LOGO[] PROGMEM={
0x00, 0x00, 0x00, 0x00, 0x00, 0x00, 0x00, 0x00, 0x00, 0x00, 0x00, 0x00, 0x00, 0x00, 0x00, 0x00,   // 0x0010 (16) pixels
0x00, 0x00, 0x00, 0x00, 0x00, 0x00, 0x00, 0x00, 0x00, 0x00, 0x00, 0x00, 0x00, 0x00, 0x00, 0x00,   // 0x0020 (32) pixels
0x00, 0x00, 0x00, 0x00, 0x00, 0x00, 0x00, 0x00, 0x00, 0x00, 0x00, 0x00, 0x00, 0x00, 0x00, 0x00,   // 0x0030 (48) pixels
0x00, 0x00, 0x00, 0x00, 0x00, 0x00, 0x00, 0x00, 0x80, 0xC0, 0xE0, 0xF0, 0xF8, 0xFC, 0xFE, 0xFC,   // 0x0040 (64) pixels
0xF8, 0xF0, 0xE0, 0xC0, 0x80, 0x00, 0x00, 0x00, 0x00, 0x00, 0x00, 0x00, 0x00, 0x00, 0x00, 0x00,   // 0x0050 (80) pixels
0x00, 0x00, 0x00, 0x00, 0x00, 0x00, 0x00, 0x00, 0x00, 0x00, 0x00, 0x00, 0x00, 0x00, 0x00, 0x00,   // 0x0060 (96) pixels
0x00, 0x00, 0x00, 0x00, 0x00, 0x00, 0x00, 0x00, 0x00, 0x00, 0x00, 0x00, 0x00, 0x00, 0x00, 0x00,   // 0x0070 (112) pixels
0x00, 0x00, 0x00, 0x00, 0x00, 0x00, 0x00, 0x00, 0x00, 0x00, 0x00, 0x00, 0x00, 0x00, 0x00, 0x00,   // 0x0080 (128) pixels
0x00, 0x00, 0x00, 0x00, 0x00, 0x00, 0x00, 0x00, 0x00, 0x00, 0x00, 0x00, 0x00, 0x00, 0x00, 0x00,   // 0x0090 (144) pixels
0x00, 0x00, 0x00, 0x00, 0x00, 0x00, 0x00, 0x00, 0x00, 0x00, 0x00, 0x00, 0x00, 0x00, 0x00, 0x00,   // 0x00A0 (160) pixels
0x00, 0x00, 0x00, 0x00, 0x00, 0x00, 0x00, 0x00, 0x00, 0x00, 0x00, 0x00, 0x00, 0x00, 0x00, 0x00,   // 0x00B0 (176) pixels
0x80, 0x80, 0x20, 0x30, 0xB8, 0xBC, 0x9E, 0x8F, 0xA7, 0xB3, 0xB9, 0xBD, 0xBD, 0x1D, 0x1D, 0x1D,   // 0x00C0 (192) pixels
0xFD, 0xF8, 0xF8, 0xF8, 0xFF, 0xFF, 0xFE, 0xFC, 0xF8, 0xF0, 0xE0, 0xC0, 0x80, 0x00, 0x00, 0x00,   // 0x00D0 (208) pixels
0x00, 0x00, 0x00, 0x00, 0x00, 0x00, 0x00, 0x00, 0x00, 0x00, 0x00, 0x00, 0x00, 0x00, 0x00, 0x00,   // 0x00E0 (224) pixels
0x00, 0x00, 0x00, 0x00, 0x00, 0x00, 0x00, 0x00, 0x00, 0x00, 0x00, 0x00, 0x00, 0x00, 0x00, 0x00,   // 0x00F0 (240) pixels
0x00, 0x00, 0x00, 0x00, 0x00, 0x00, 0x00, 0x00, 0x00, 0x00, 0x00, 0x00, 0x00, 0x00, 0x00, 0x00,   // 0x0100 (256) pixels
0x00, 0x00, 0x00, 0x00, 0x00, 0x00, 0x00, 0x00, 0x00, 0x00, 0x00, 0x00, 0x00, 0x00, 0x00, 0x00,   // 0x0110 (272) pixels
0x00, 0x00, 0x00, 0x00, 0x00, 0x00, 0x00, 0x00, 0x00, 0x00, 0x00, 0x00, 0x00, 0x00, 0x00, 0x00,   // 0x0120 (288) pixels
0x00, 0x00, 0x00, 0x00, 0x00, 0x00, 0x00, 0x00, 0x80, 0xC0, 0xE0, 0xF0, 0xF8, 0xFC, 0xFE, 0xFF,   // 0x0130 (304) pixels
0xFF, 0x7F, 0x3F, 0xBE, 0xBC, 0xB9, 0xBB, 0xBB, 0xBB, 0xBB, 0xBB, 0xBB, 0x1B, 0x1B, 0x1B, 0xFB,   // 0x0140 (320) pixels
0xFB, 0xFB, 0xFB, 0xFB, 0xFB, 0xF1, 0xF1, 0xF1, 0xFF, 0xFF, 0xFF, 0xFF, 0xFF, 0xFF, 0xFE, 0xFC,   // 0x0150 (336) pixels
0xF8, 0xF0, 0xE0, 0xC0, 0x80, 0x00, 0x00, 0x00, 0x00, 0x00, 0x00, 0x00, 0x00, 0x00, 0x00, 0x00,   // 0x0160 (352) pixels
0x00, 0x00, 0x00, 0x00, 0x00, 0x00, 0x00, 0x00, 0x00, 0x00, 0x00, 0x00, 0x00, 0x00, 0x00, 0x00,   // 0x0170 (368) pixels
0x00, 0x00, 0x00, 0x00, 0x00, 0x00, 0x00, 0x00, 0x00, 0x00, 0x00, 0x00, 0x00, 0x00, 0x00, 0x00,   // 0x0180 (384) pixels
0x00, 0x00, 0x00, 0x00, 0x00, 0x00, 0x00, 0x00, 0x00, 0x00, 0x00, 0x00, 0x00, 0x00, 0x00, 0x00,   // 0x0190 (400) pixels
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
0x1F, 0x1F, 0x1F, 0x1F, 0x1F, 0x1F, 0x1F, 0x1F, 0x1F, 0x1F, 0x1F, 0x1F, 0x1F, 0x1F, 0x1F, 0x1F,   // 0x03C0 (960) pixels
0x1F, 0x1F, 0x1F, 0x1F, 0x1F, 0x1F, 0x1F, 0x1F, 0x1F, 0x1F, 0x1F, 0x1E, 0x1E, 0x1E, 0x1C, 0x1C,   // 0x03D0 (976) pixels
0x1C, 0x18, 0x18, 0x18, 0x10, 0x10, 0x13, 0x1E, 0x18, 0x00, 0x00, 0x00, 0x00, 0x00, 0x00, 0x00,   // 0x03E0 (992) pixels
0x00, 0x00, 0x00, 0x00, 0x00, 0x00, 0x00, 0x00, 0x00, 0x00, 0x00, 0x00, 0x00, 0x00, 0x00, 0x00,   // 0x03F0 (1008) pixels
0x00, 0x00, 0x00, 0x00, 0x00, 0x00, 0x00, 0x00, 0x00, 0x00, 0x00, 0x00, 0x00, 0x00, 0x00, 0x00,   // 0x0400 (1024) pixels
};

#endif
