arquero99/E-TEASPILS/SW/V3_TeaSpike/include/credentials example.h

#ifndef CREDENTIALS_HPP
#define CREDENTIALS_HPP

#define UNIVERSITY "your university name"

//wifi credentials

#define WIFI_NAME             "your wifi ssid"
#define WIFI_PASSWORD       "your wifi password"

//thingsboard credentials

#define TOKEN   "your Thingsboard token" //TeaSpike PHW 1
#define THINGSBOARD_SERVER   "thingsboard.cloud"

//telegram

#define tokenBot "your bot's token"
#endif
