arquero99/E-TEASPILS/(commit log)

2022-05-29 Updating filesystem to Viena congess
    [1Día(Rand).csv, 1Día(Rand)NameType.csv, Adafruit PowerBoost 1000 Basic.brd, Adafruit PowerBoost 1000 Basic.sch, Components.xlsx, Esquema.fzz, PowerConsumption.xlsx, Semanal(7-02_15_02).csv]
2022-06-05 Added 3D Model of PCB
2022-09-12 Version 2.0
    [configuration.h]
2022-09-12 Version 2.1
    [configuration.h]
2022-11-17 Version 3
    [configuration.h]
